rjw57/simplest-80s-computer/README.md

# Experimental repo for retro computing

This is my rough scratch repo where I keep experiments to do with desiging 80s
computer peripherals. It is not in any sensible shape to be used by others yet,
apologies.
