rjw57/simplest-80s-computer/vga-test/tidied-schematic.pdf

## VCC

## VCC

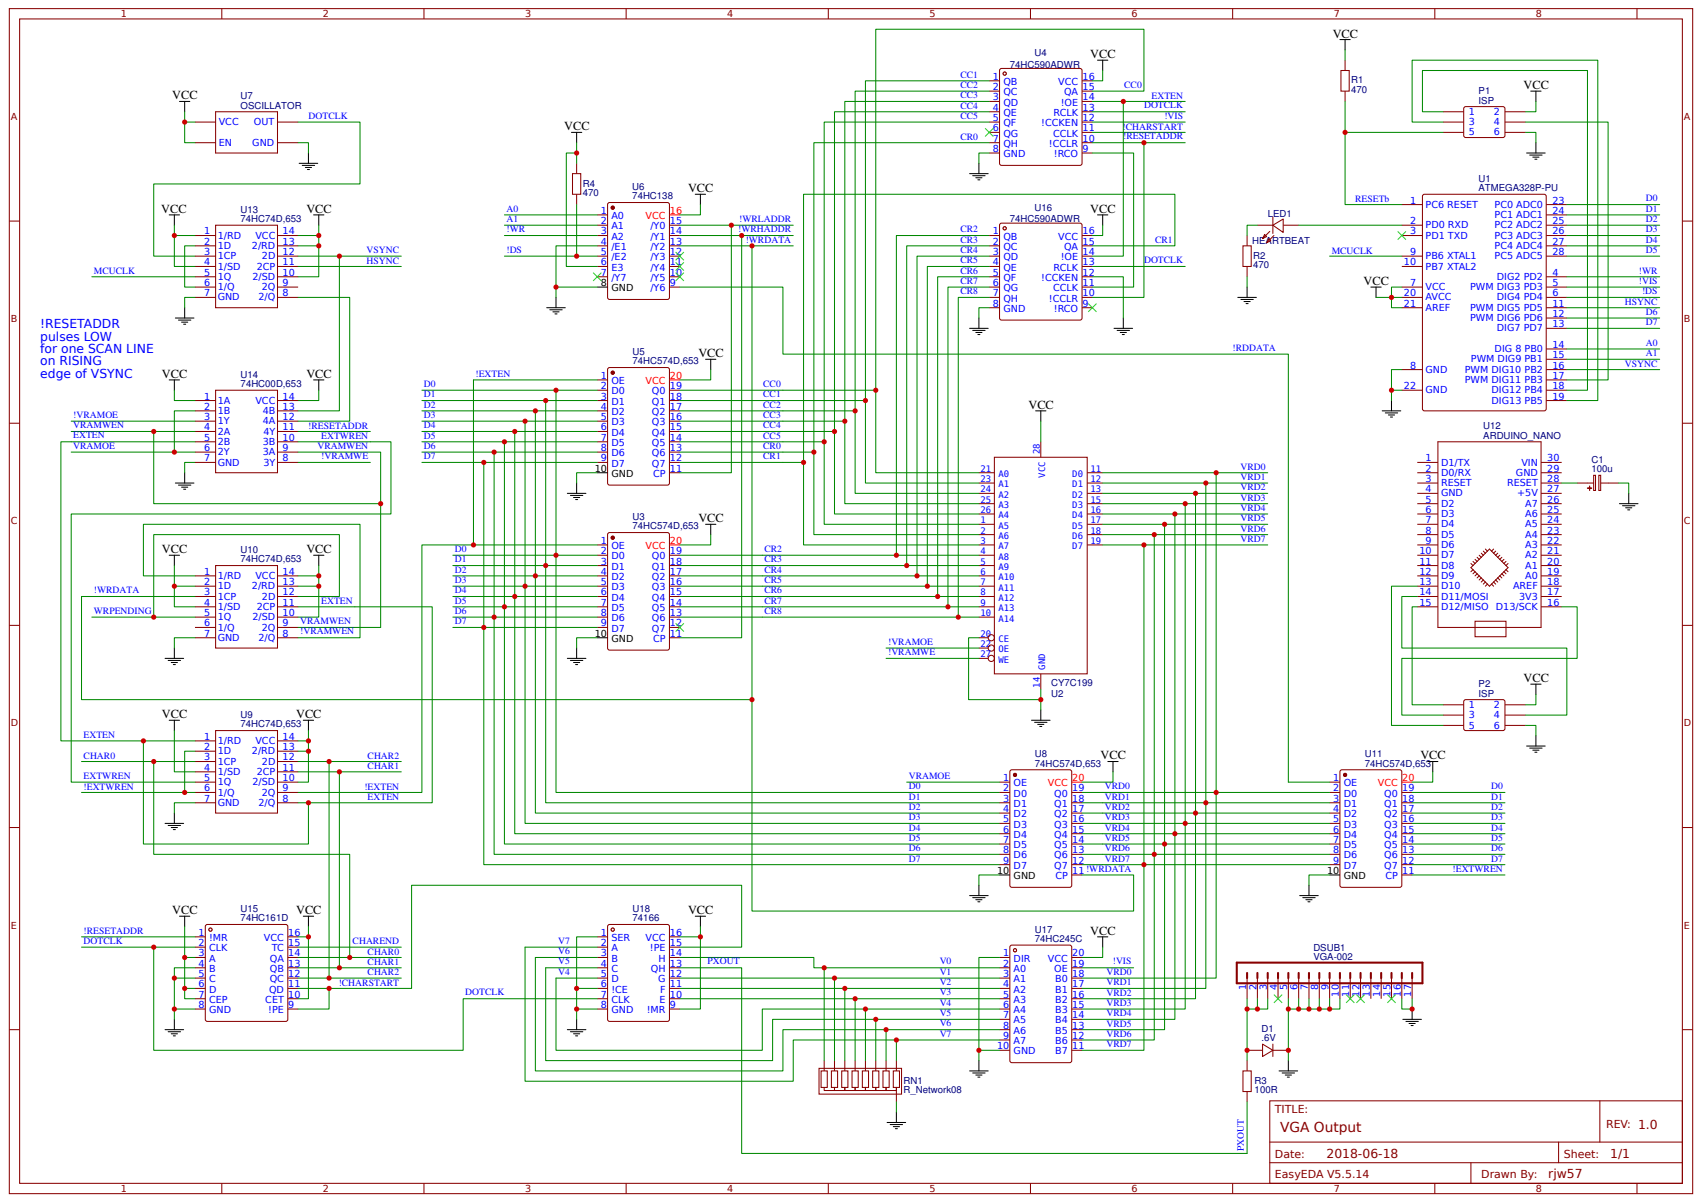
[picture p1: page 1]

!RESETADDR
pulses LOW
for one SCAN LINE
on RISING
edge of VSYNC
