rjw57/simplest-80s-computer/vga-test/working-schematic.pdf

## VCC

## VCC

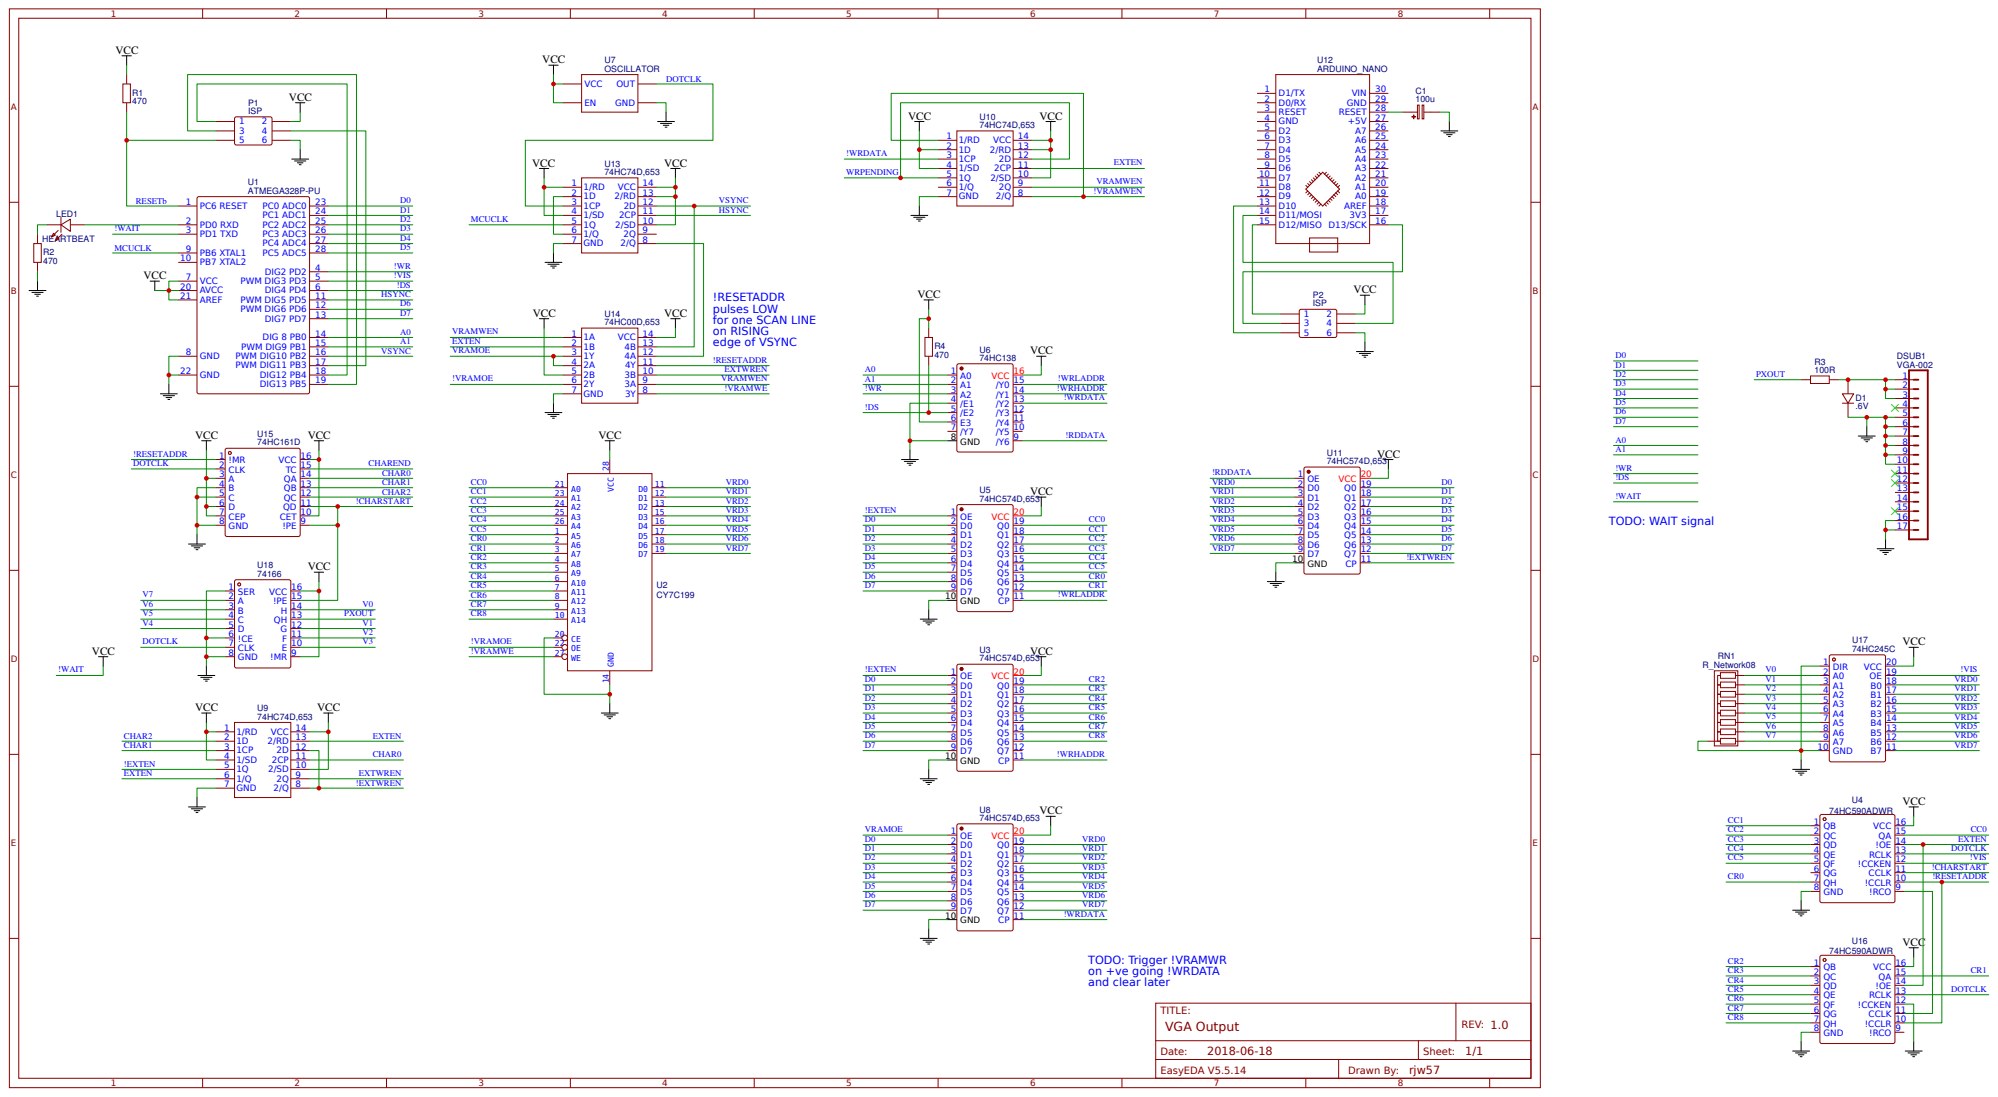
[picture p2: page 1]

TODO: Trigger !VRAMWR
on +ve going !WRDATA
and clear later
