rjw57/simplest-80s-computer/vga-test/plots/vga-draft1.pdf

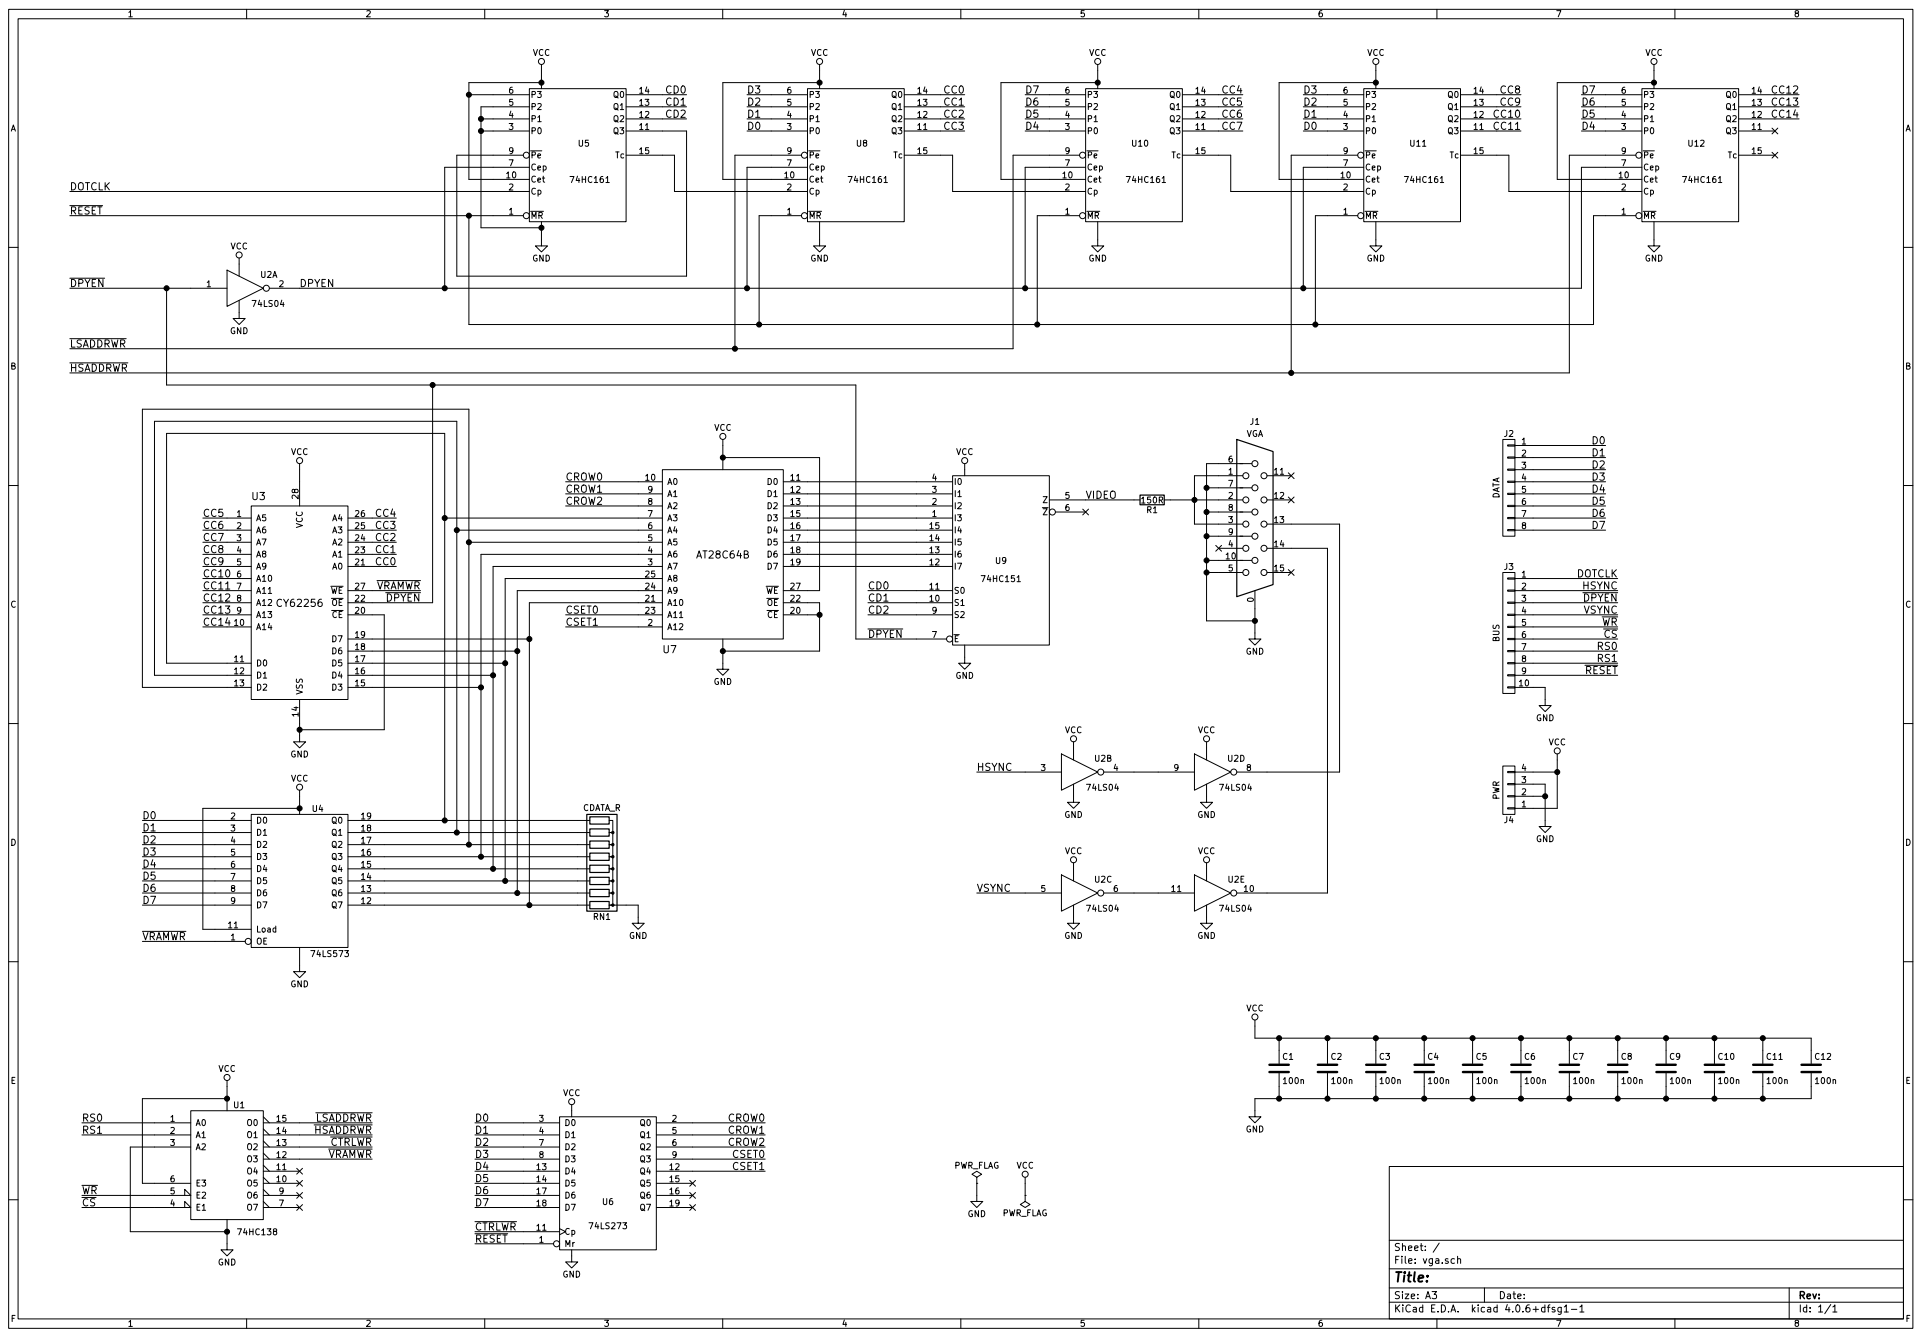
[picture p3: page 1]

Id: 1/1 Title: File: vga.sch Sheet: /
