rjw57/simplest-80s-computer/vga/hw/vga/vga.kicad_pcb

## KiCad design vga/hw/vga/vga.kicad_pcb (2018-07-28)

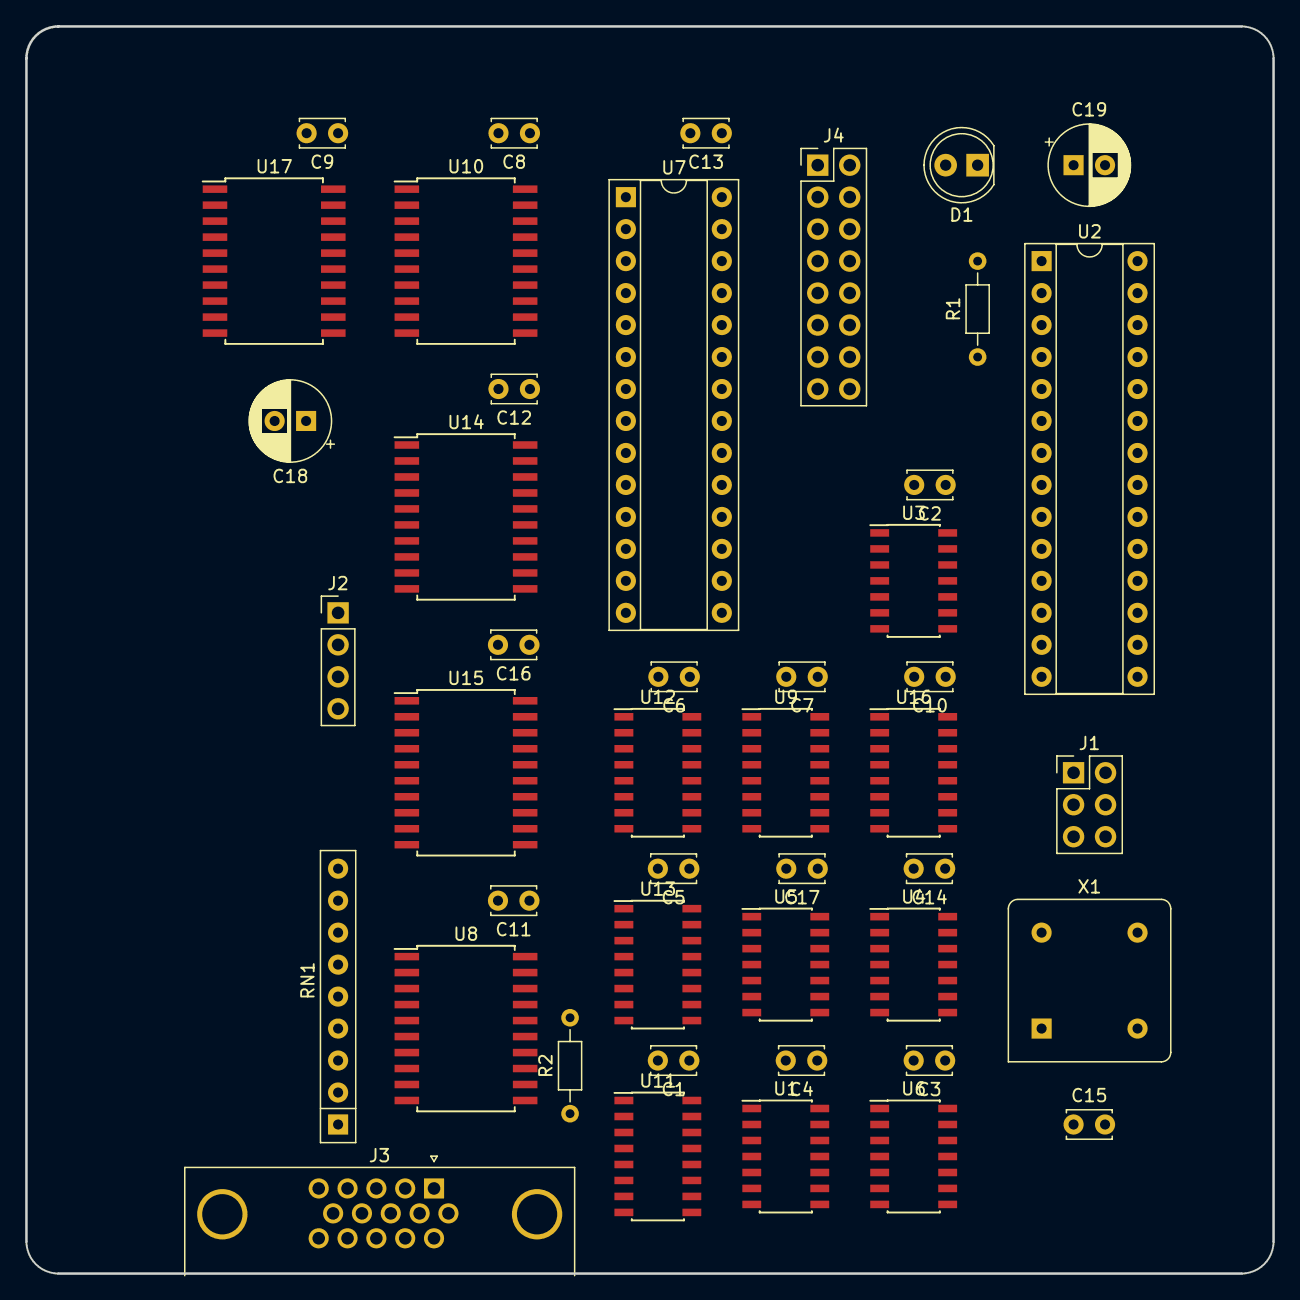
[picture p5: board vga.kicad_pcb from above]

Board: 2 copper layers, 99.1 x 99.1 mm, 45 parts (0 on the bottom side), 81 nets, no tracks yet.

Parts:
C1, C2, C3, C4, C5, C6, C7, C8, C9, C10, C11, C12, C13, C14, C15, C16, C17: 100n; C_Disc_D3.4mm_W2.1mm_P2.50mm
C18: 10µ; CP_Radial_D6.3mm_P2.50mm
C19: 100µ; CP_Radial_D6.3mm_P2.50mm
D1: LED; LED_D5.0mm
J1: ISP; PinHeader_2x03_P2.54mm_Vertical
J2: PWR; PinHeader_1x04_P2.54mm_Vertical
J3: VGA; DSUB-15-HD_Female_Horizontal_P2.29x1.98mm_EdgePinOffset3.03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
J4: BUS; PinHeader_2x08_P2.54mm_Vertical
R1: 470R; R_Axial_DIN0204_L3.6mm_D1.6mm_P7.62mm_Horizontal
R2: 100R; R_Axial_DIN0204_L3.6mm_D1.6mm_P7.62mm_Horizontal
RN1: R_Network08; R_Array_SIP9
U1, U5, U6: 74HC74; SOIC-14_3.9x8.7mm_P1.27mm
U2: ATmega328-PU; DIP-28_W7.62mm_Socket
U3: 74HC00; SOIC-14_3.9x8.7mm_P1.27mm
U4: 74HC04; SOIC-14_3.9x8.7mm_P1.27mm
U7: CY7C199; DIP-28_W7.62mm_Socket
U8: 74HC245; SOIC-20W_7.5x12.8mm_P1.27mm
U9: 74HC161; SOIC-16_3.9x9.9mm_P1.27mm
U10, U14, U15, U17: 74HC574; SOIC-20W_7.5x12.8mm_P1.27mm
U11: 74HC166; SOIC-16_3.9x9.9mm_P1.27mm
U12, U13: 74HC590; SOIC-16_3.9x9.9mm_P1.27mm
U16: 74LS138; SOIC-16_3.9x9.9mm_P1.27mm
X1: DOTCLK; Oscillator_DIP-8

Connections:
+5V: C1.1, C2.1, C3.1, C4.1, C5.1, C6.1, C7.1, C8.1, C9.1, C10.1, C11.1, C12.1, C13.1, C14.1, C15.1, C16.1, C17.1, C18.1, C19.1, D1.2, J1.2, J2.1, J2.4, J4.2, R1.1, U1.1, U1.4, U1.10, U1.13, U1.14, U2.7, U2.20, U2.21, U3.14, U4.14, U5.1, U5.4, U5.10, U5.14, U6.1, U6.4, U6.10, U6.12, U6.14, U7.28, U8.20, U9.3, U9.6, U9.7, U9.10, U9.16, U10.20, U11.9, U11.16, U12.16, U13.16, U14.20, U15.20, U16.6, U16.16, U17.20, X1.1, X1.8
/A0: J4.4, U16.1
/A1: J4.6, U16.2
/C0: U7.21, U10.19, U12.15
/C1: U7.23, U10.18, U12.1
/C2: U7.24, U10.17, U12.2
/C3: U7.25, U10.16, U12.3
/C4: U7.26, U10.15, U12.4
/C5: U7.1, U10.14, U12.5
/CDOT0: U5.11, U9.14
/CDOT1: U5.3, U9.13
/CDOT2: U5.2, U9.12
/D0: J4.1, U10.2, U14.2, U15.2, U17.19
/D1: J4.3, U10.3, U14.3, U15.3, U17.18
/D2: J4.5, U10.4, U14.4, U15.4, U17.17
/D3: J4.7, U10.5, U14.5, U15.5, U17.16
/D4: J4.9, U10.6, U14.6, U15.6, U17.15
/D5: J4.11, U10.7, U14.7, U15.7, U17.14
/D6: J4.13, U10.8, U14.8, U15.8, U17.13
/D7: J4.15, U10.9, U14.9, U15.9, U17.12
/DOTCLK: U1.3, U4.6, U9.2, U11.7, U12.13, U13.13
/EXTEN: U3.2, U5.6, U5.13, U6.3, U12.14, U13.14
/EXTWREN: U3.5, U5.9
/HSYNC: J3.13, U4.2
/MCUCLK: U1.5, U2.9
/MISO: J1.1, U2.18
/MOSI: J1.4, U2.17
/R0: U7.2, U10.13, U12.7
/R1: U7.3, U10.12, U13.15
/R2: U7.4, U13.1, U14.19
/R3: U7.5, U13.2, U14.18
/R4: U7.6, U13.3, U14.17
/R5: U7.7, U13.4, U14.16
/R6: U7.8, U13.5, U14.15
/R7: U7.9, U13.6, U14.14
/R8: U7.10, U13.7, U14.13
/SCK: J1.3, U2.19
/V0: RN1.9, U8.2, U11.14
/V1: RN1.8, U8.3, U11.12
/V2: RN1.7, U8.4, U11.11
/V3: RN1.6, U8.5, U11.10
/V4: RN1.5, U8.6, U11.5
/V5: RN1.4, U8.7, U11.4
/V6: RN1.3, U8.8, U11.3
/V7: RN1.2, U8.9, U11.2
/VD0: U7.11, U8.18, U15.19, U17.2
/VD1: U7.12, U8.17, U15.18, U17.3
/VD2: U7.13, U8.16, U15.17
/VD3: U7.15, U8.15, U15.16
/VD4: U7.16, U8.14, U15.15, U17.6
/VD5: U7.17, U8.13, U15.14, U17.7
/VD6: U7.18, U8.12, U15.13, U17.8
/VD7: U7.19, U8.11, U15.12, U17.9
/VRAMOE: U3.3, U4.9, U15.1
/VRAMWREN: U3.1, U3.4, U6.5
/VSYNC: J3.14, U4.4
/WRPENDING: U6.2, U6.9
/~CSTART: U9.9, U9.11, U11.15, U12.11
/~EXTEN: U5.5, U10.1, U14.1
/~EXTWREN: U5.8, U5.12, U17.11
/~HSYNC: U1.11, U2.11, U4.1
/~ISPRST: J1.5, R1.2, U2.1
/~RD: J4.8, U17.1
/~RSTCOUNT: U3.8, U9.1, U12.10, U13.10
/~VIS: U2.5, U8.19, U12.12
/~VRAMOE: U4.8, U7.22
/~VRAMWE: U3.6, U7.27
/~VRAMWREN: U6.6, U6.13
/~VSYNC: U1.12, U2.16, U3.10, U4.3
/~WR: J4.10, U16.5
/~WRDATA: U6.11, U15.11, U16.13
/~WRHADDR: U14.11, U16.14
/~WRLADDR: U10.11, U16.15
GND: C1.2, C2.2, C3.2, C4.2, C5.2, C6.2, C7.2, C8.2, C9.2, C10.2, C11.2, C12.2, C13.2, C14.2, C15.2, C16.2, C17.2, C18.2, C19.2, J1.6, J2.2, J2.3, J3.0, J3.5, J3.6, J3.7, J3.8, J3.9, J3.10, J4.12, J4.14, J4.16, RN1.1, U1.7, U2.8, U2.22, U3.7, U4.7, U5.7, U6.7, U7.14, U7.20, U8.1, U8.10, U9.4, U9.5, U9.8, U10.10, U11.1, U11.6, U11.8, U12.8, U13.8, U13.12, U14.10, U15.10, U16.3, U16.4, U16.8, U17.10, X1.4
unnamed: D1.1, U2.2
unnamed: J3.1, J3.2, J3.3, R2.1
unnamed: R2.2, U11.13
unnamed: U1.2, U1.6
unnamed: U1.8, U3.9
unnamed: U4.5, X1.5
unnamed: U12.9, U13.11
