rjw57/simplest-80s-computer/hw/computer.kicad_pcb

## KiCad design hw/computer.kicad_pcb (2018-05-28)

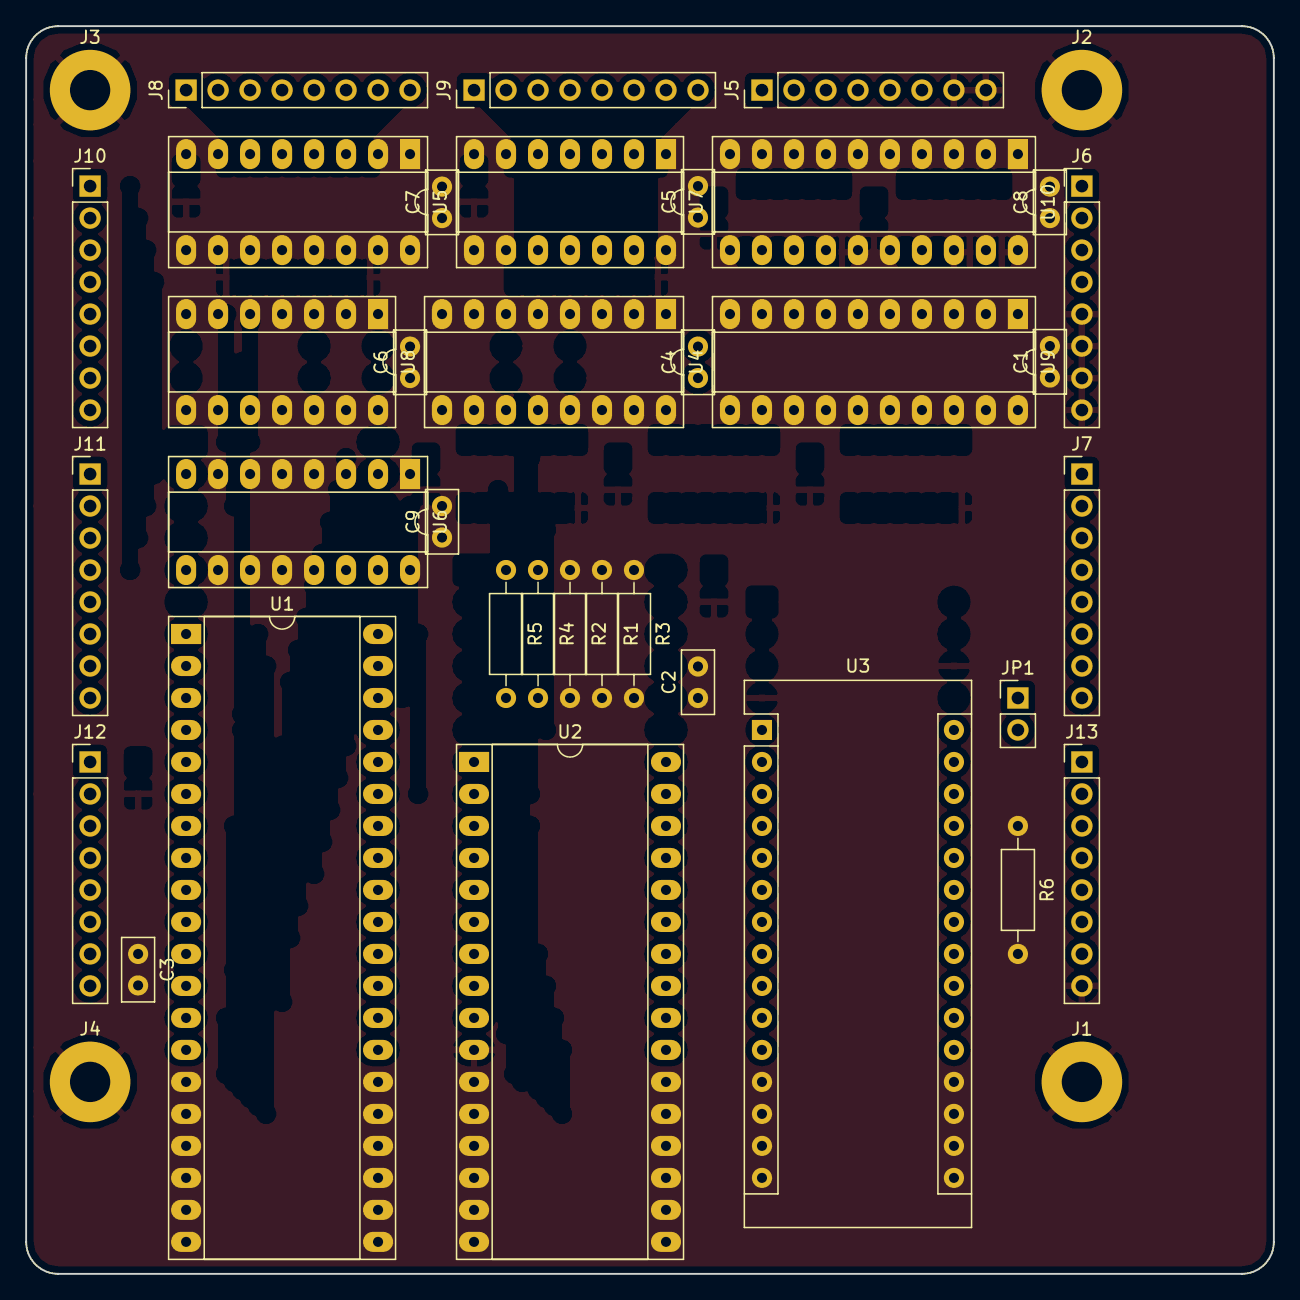
[picture p6: board computer.kicad_pcb from above]

Board: 2 copper layers, 99.1 x 99.1 mm, 39 parts (0 on the bottom side), 71 nets, no tracks yet.

Parts:
C1, C2, C3, C4, C5, C6, C7, C8, C9: 100n; C_Disc_D5.0mm_W2.5mm_P2.50mm
J1, J2, J3, J4: MOUNT; MountingHole_3.2mm_M3_Pad
J5: POWER; Pin_Header_Straight_1x08_Pitch2.54mm
J6: PORTA; Pin_Header_Straight_1x08_Pitch2.54mm
J7: PORTB; Pin_Header_Straight_1x08_Pitch2.54mm
J8: ADDR2; Pin_Header_Straight_1x08_Pitch2.54mm
J9: ADDR1; Pin_Header_Straight_1x08_Pitch2.54mm
J10: DATA; Pin_Header_Straight_1x08_Pitch2.54mm
J11: CPU1; Pin_Header_Straight_1x08_Pitch2.54mm
J12: CPU2; Pin_Header_Straight_1x08_Pitch2.54mm
J13: NANO; Pin_Header_Straight_1x08_Pitch2.54mm
JP1: NANO PWR; Pin_Header_Straight_1x02_Pitch2.54mm
R1, R2, R3, R4, R5, R6: 330R; R_Axial_DIN0207_L6.3mm_D2.5mm_P10.16mm_Horizontal
U1: Z84C00; DIP-40_W15.24mm_Socket_LongPads
U2: AS6C4008; DIP-32_W15.24mm_Socket_LongPads
U3: Nano; Arduino_Nano
U4, U5, U6: 74HC595; DIP-16_W7.62mm_Socket_LongPads
U7: 74HC30; DIP-14_W7.62mm_Socket_LongPads
U8: 74HC27; DIP-14_W7.62mm_Socket_LongPads
U9, U10: 74HC573; DIP-20_W7.62mm_Socket_LongPads

Connections:
/A0: J9.8, U1.30, U2.12, U4.15, U7.1
/A1: J9.7, U1.31, U2.11, U4.1, U7.2
/A2: J9.6, U1.32, U2.10, U4.2, U7.3
/A3: J9.5, U1.33, U2.9, U4.3, U7.4
/A4: J9.4, U1.34, U2.8, U4.4, U7.5
/A5: J9.3, U1.35, U2.7, U4.5, U7.6
/A6: J9.2, U1.36, U2.6, U4.6, U7.11
/A7: J9.1, U1.37, U2.5, U4.7, U7.12
/A8: J8.8, U1.38, U2.4, U5.15
/A9: J8.7, U1.29, U2.3, U5.1
/A10: J8.6, U1.40, U2.25, U5.2
/A11: J8.5, U1.1, U2.23, U5.3
/A12: J8.4, U1.2, U2.26, U5.4
/A13: J8.3, U1.3, U2.27, U5.5
/A14: J8.2, U1.4, U2.28, U5.6
/A15: J8.1, U1.5, U2.31, U5.7
/Arduino/ARCLK: U3.15, U4.12, U5.12, U6.12
/Arduino/ASCLK: U3.16, U4.11, U5.11, U6.11
/Arduino/ASDA: U3.14, U4.14
/Arduino/~AOE: R6.2, U3.12, U4.13, U5.13, U6.13
/CLK: J12.7, U1.6, U3.11
/D0: J10.1, U1.14, U2.15, U3.19, U9.19, U10.2
/D1: J10.2, U1.15, U2.14, U3.20, U9.18, U10.3
/D2: J10.3, U1.12, U2.13, U3.21, U9.17, U10.4
/D3: J10.4, U1.8, U2.17, U3.22, U9.16, U10.5
/D4: J10.5, U1.7, U2.18, U3.23, U9.15, U10.6
/D5: J10.6, U1.9, U2.19, U3.24, U9.14, U10.7
/D6: J10.7, U1.10, U2.20, U3.9, U9.13, U10.8
/D7: J10.8, U1.13, U2.21, U3.10, U9.12, U10.9
/IO Ports/PA0: J6.1, U10.19
/IO Ports/PA1: J6.2, U10.18
/IO Ports/PA2: J6.3, U10.17
/IO Ports/PA3: J6.4, U10.16
/IO Ports/PA4: J6.5, U10.15
/IO Ports/PA5: J6.6, U10.14
/IO Ports/PA6: J6.7, U10.13
/IO Ports/PA7: J6.8, U10.12
/IO Ports/PB0: J7.1, U9.2
/IO Ports/PB1: J7.2, U9.3
/IO Ports/PB2: J7.3, U9.4
/IO Ports/PB3: J7.4, U9.5
/IO Ports/PB4: J7.5, U9.6
/IO Ports/PB5: J7.6, U9.7
/IO Ports/PB6: J7.7, U9.8
/IO Ports/PB7: J7.8, U9.9
/IO Ports/WRPA: U8.8, U10.11
/IO Ports/~ADDR0: U7.8, U8.10, U8.13
/IO Ports/~RDPB: U8.6, U9.1, U9.11
/~BUSAK: J11.6, U1.23
/~BUSRQ: J12.6, R1.2, U1.25
/~HALT: J11.1, U1.18
/~INT: J12.2, R5.2, U1.16
/~IORQ: J11.3, U1.20, U6.3, U8.2, U8.9
/~M1: J11.7, U1.27
/~MREQ: J11.2, U1.19, U2.22, U6.2
/~NMI: J12.3, R4.2, U1.17
/~RD: J11.4, U1.21, U2.24, U6.15, U8.1
/~RESET: J12.4, R3.2, U1.26, U3.7
/~RFSH: J11.8, U1.28
/~WAIT: J12.5, R2.2, U1.24
/~WR: J11.5, U1.22, U2.29, U6.1, U8.11
GND: C1.2, C2.2, C3.2, C4.2, C5.2, C6.2, C7.2, C8.2, C9.2, J1.1, J2.1, J3.1, J4.1, J5.5, J5.6, J5.7, J5.8, J12.8, J13.7, J13.8, U2.16, U3.4, U3.28, U4.8, U5.8, U6.8, U7.7, U8.4, U8.5, U8.7, U9.10, U10.1, U10.10
unnamed: J13.1, J13.2, JP1.1, U3.27
unnamed: J13.3, U3.5
unnamed: J13.4, U3.6
unnamed: J13.5, U3.8
unnamed: J13.6, U3.13
unnamed: U4.9, U5.14
unnamed: U5.9, U6.14
unnamed: U8.3, U8.12
VCC: C1.1, C2.1, C3.1, C4.1, C5.1, C6.1, C7.1, C8.1, C9.1, J5.1, J5.2, J5.3, J5.4, J12.1, JP1.2, R1.1, R2.1, R3.1, R4.1, R5.1, R6.1, U1.11, U2.1, U2.2, U2.30, U2.32, U4.10, U4.16, U5.10, U5.16, U6.10, U6.16, U7.14, U8.14, U9.20, U10.20
