rjw57/simplest-80s-computer/(commit log)

2018-04-15 initial import
    [computer.kicad_pcb, computer.sch, video_addr.sch]
2018-05-28 draft of VGA controller
    [_saved_io_addr_decode.sch, addr_decode.sch, arduino.sch, computer.kicad_pcb, computer.sch, ioports.sch, vga.kicad_pcb, vga.sch]
2018-06-04 update VGA to latest version
    [vga.sch]
2018-06-09 re-worked timings
    Now AVR generates HSYNC, VSYNC and VIS itself using timers with no
    external circuitry!
    [vga.sch]
2018-06-09 move to 512x384 output resolution
    By halving 1024x768 we can nicely separate row and column bits which
    will simplify circuitry.
    [vga.sch]
2018-07-08 removed old schematic and update fw
    [vga.kicad_pcb, vga.sch]
2018-07-08 update schematic
2018-07-10 added tidied up schematic
2018-07-15 start sketching out vga scheatic in kicad
    [vga.kicad_pcb, vga.sch]
2018-07-21 start to transfer schematic to kicad
    [vga.sch]
2018-07-21 add RAM in
    [vga.kicad_pcb, vga.sch]
2018-07-21 add bus interface header
    [vga.sch]
2018-07-28 flesh out PCB
    [vga.kicad_pcb, vga.sch]
